GlobalSequence/quadulator/hardware/schematic.pdf

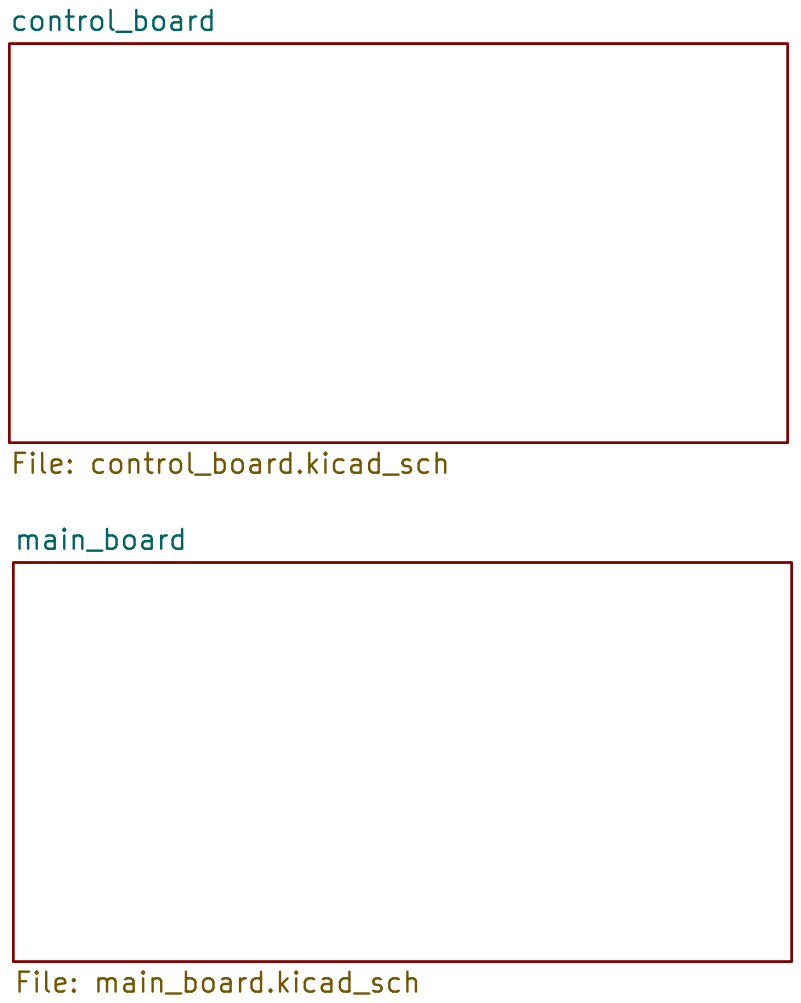
[picture p1: page 1]

Id: 1/3 Title: File: 2024.11.21_quadulator_2.0.kicad_sch Sheet: / main_board File: main_board.kicad_sch

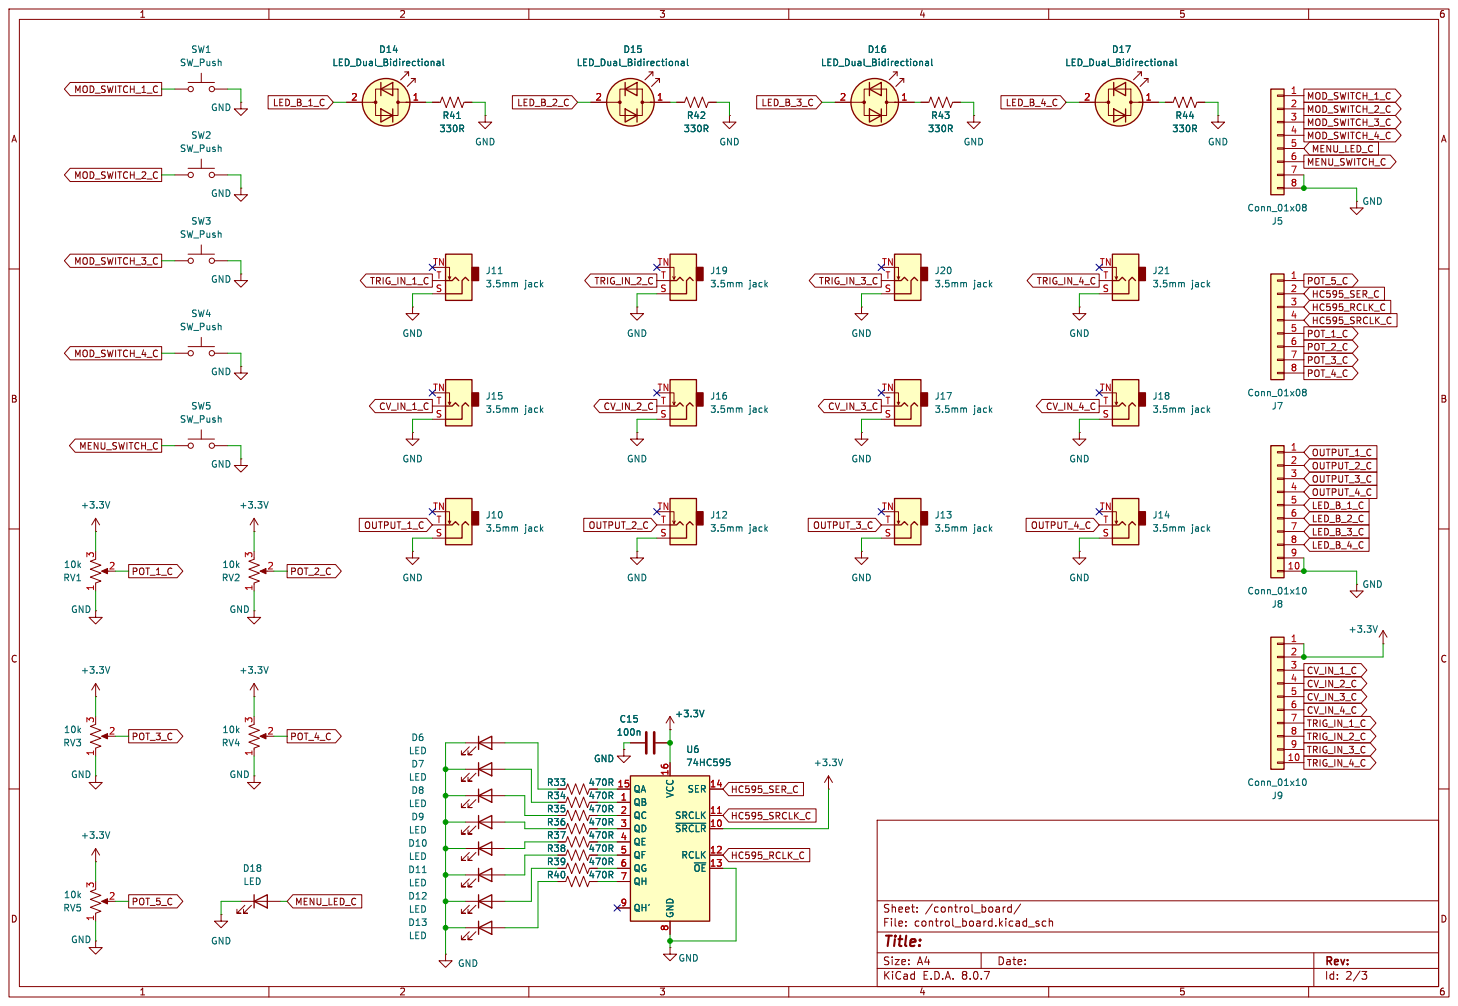
[picture p2: page 2]

Id: 2/3 Title: File: control_board.kicad_sch Sheet: /control_board/

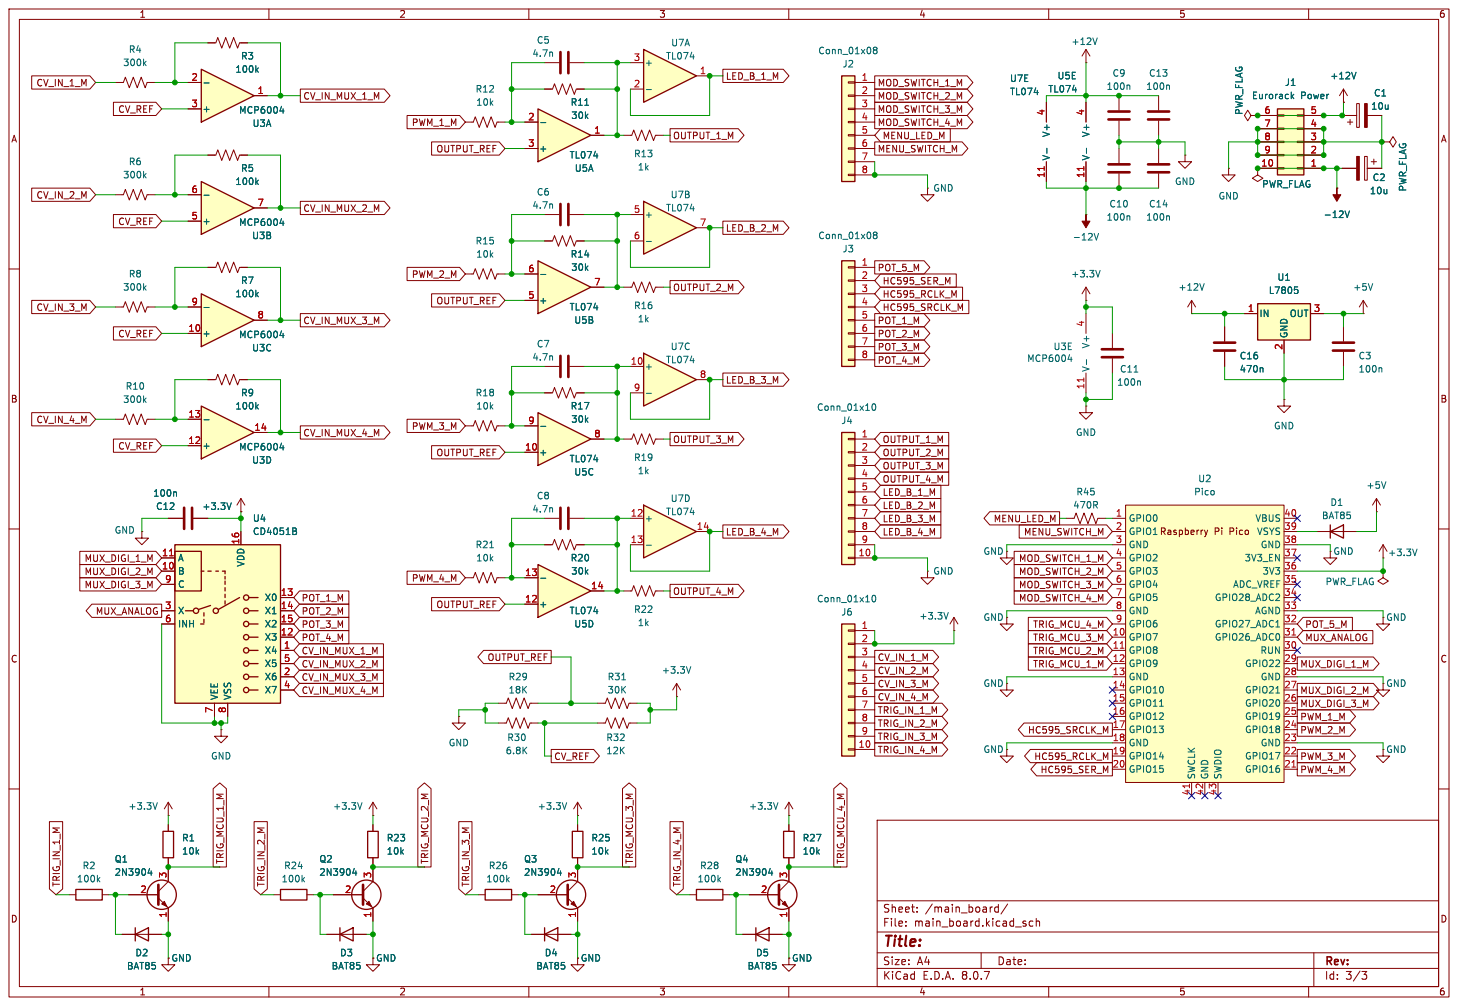
[picture p3: page 3]
