GlobalSequence/quadulator/hardware/quadulator.kicad_pcb

## KiCad design hardware/quadulator.kicad_pcb (2025-01-12)

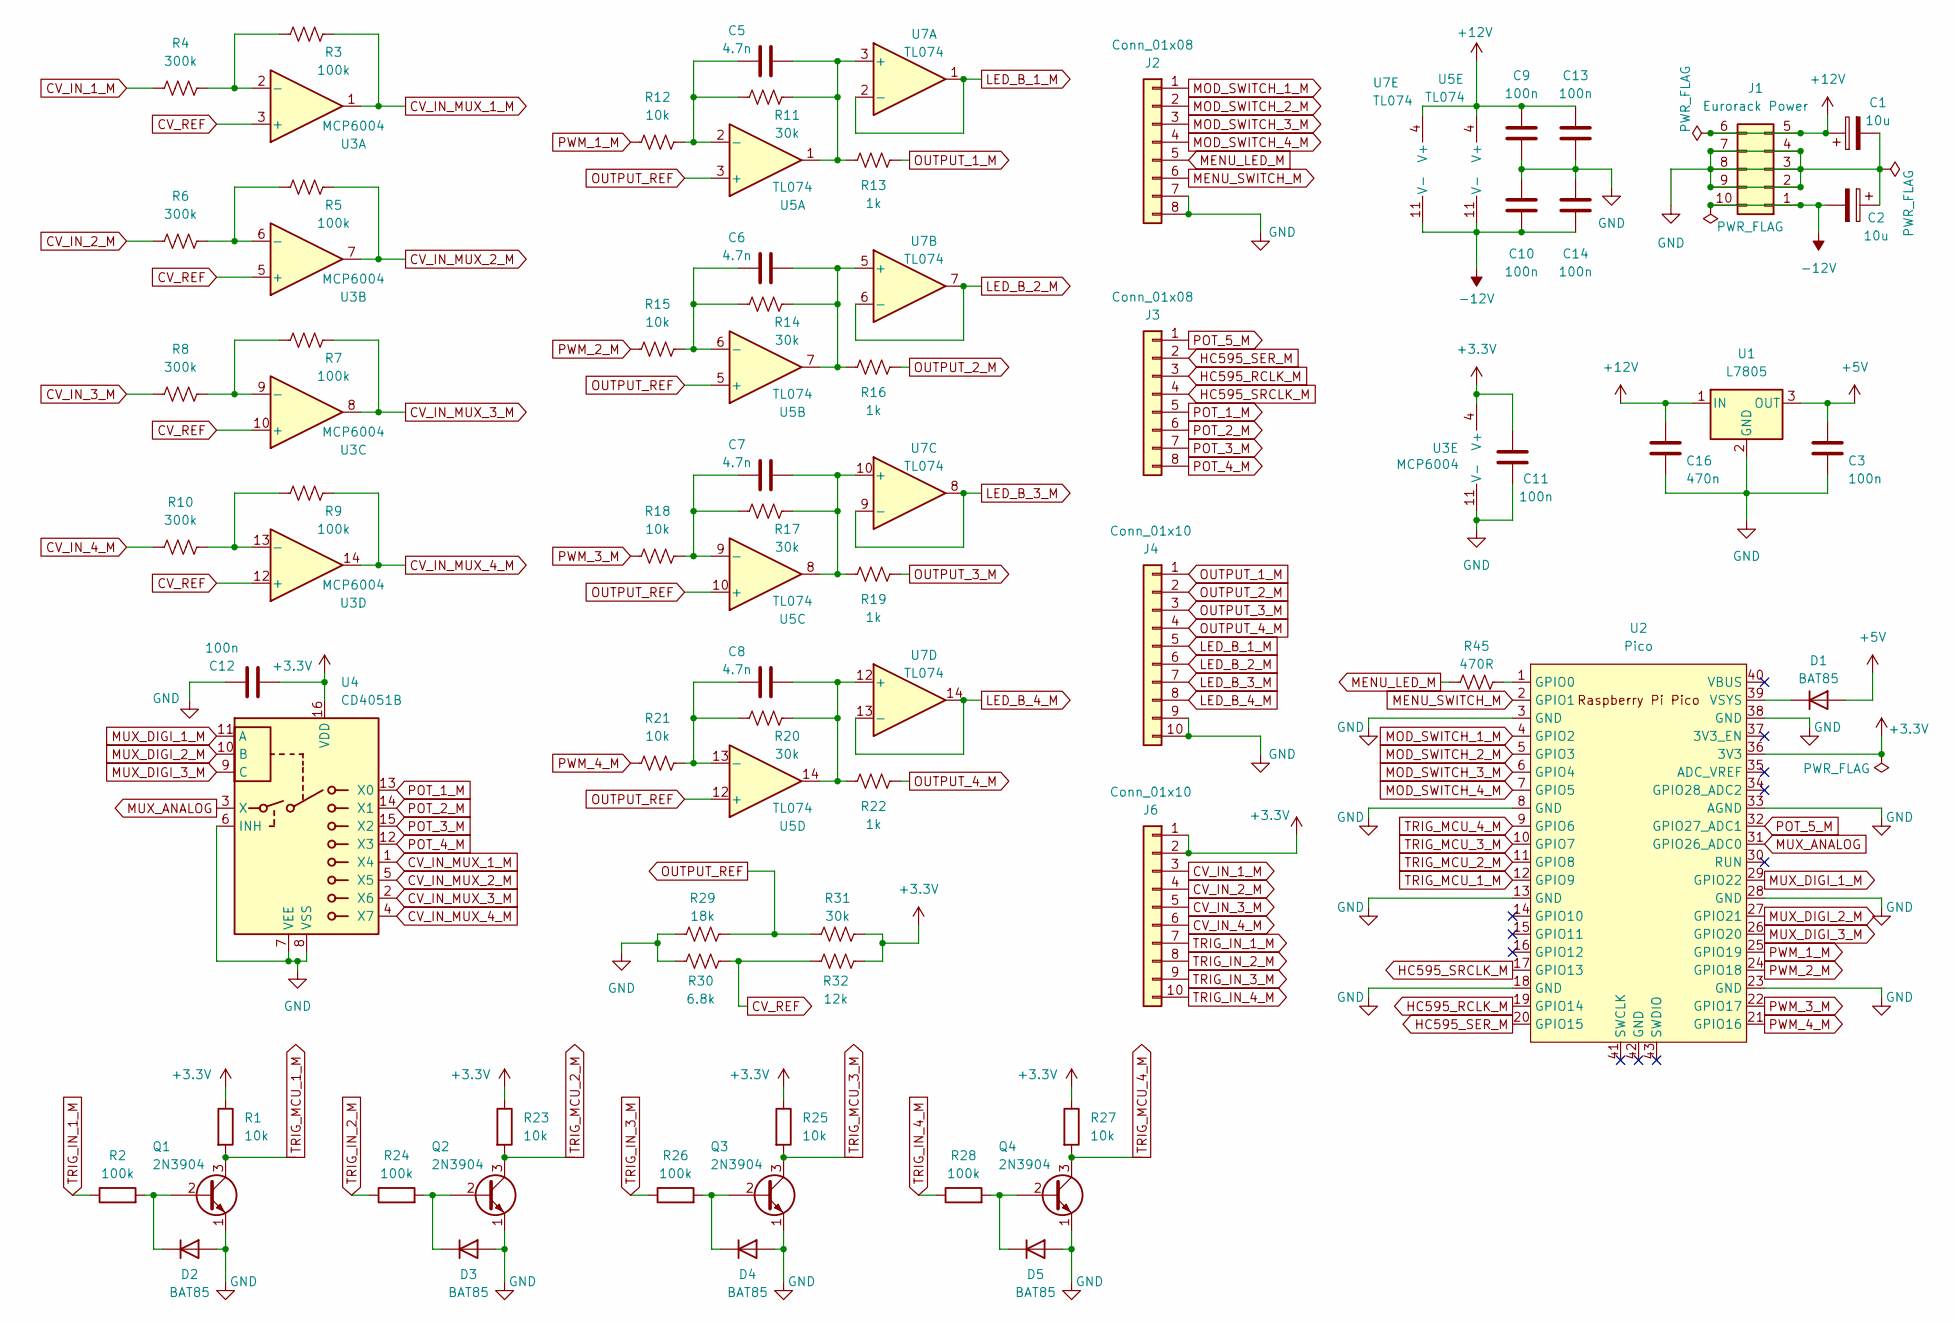
[picture p4: schematic main_board.kicad_sch]

Parts:
C1, C2: 10u; CP_Radial_D5.0mm_P2.50mm
C3, C9, C10, C11, C12, C13, C14: 100n; C_Disc_D5.0mm_W2.5mm_P5.00mm
C5, C6, C7, C8: 4.7n; C_Disc_D5.0mm_W2.5mm_P5.00mm
C16: 470n; C_Disc_D5.0mm_W2.5mm_P5.00mm
D1, D2, D3, D4, D5: BAT85; D_A-405_P7.62mm_Horizontal
J1: Eurorack Power; IDC-Header_2x05_P2.54mm_Vertical
J2, J3: Conn_01x08; PinSocket_1x08_P2.54mm_Vertical
J4, J6: Conn_01x10; PinSocket_1x10_P2.54mm_Vertical
Q1, Q2, Q3, Q4: 2N3904; TO-92L_Inline_Wide
R1, R12, R15, R18, R21, R23, R25, R27: 10k; R_Axial_DIN0207_L6.3mm_D2.5mm_P7.62mm_Horizontal
R2, R3, R5, R7, R9, R24, R26, R28: 100k; R_Axial_DIN0207_L6.3mm_D2.5mm_P7.62mm_Horizontal
R4, R6, R8, R10: 300k; R_Axial_DIN0207_L6.3mm_D2.5mm_P7.62mm_Horizontal
R11, R14, R17, R20, R31: 30k; R_Axial_DIN0207_L6.3mm_D2.5mm_P7.62mm_Horizontal
R13, R16, R19, R22: 1k; R_Axial_DIN0207_L6.3mm_D2.5mm_P7.62mm_Horizontal
R29: 18k; R_Axial_DIN0207_L6.3mm_D2.5mm_P7.62mm_Horizontal
R30: 6.8k; R_Axial_DIN0207_L6.3mm_D2.5mm_P7.62mm_Horizontal
R32: 12k; R_Axial_DIN0207_L6.3mm_D2.5mm_P7.62mm_Horizontal
R45: 470R; R_Axial_DIN0207_L6.3mm_D2.5mm_P7.62mm_Horizontal
U1: L7805; TO-220-3_Vertical
U2: Pico; RPi_Pico_SMD_TH
U3: MCP6004; DIP-14_W7.62mm_Socket
U4: CD4051B; DIP-16_W7.62mm_Socket
U5, U7: TL074; DIP-14_W7.62mm_Socket

Connections:
+3.3V: C11.1, C12.2, J6.1, J6.2, R1.1, R23.1, R25.1, R27.1, R31.2, R32.1, U2.36 (3V3), U3.4 (V+), U4.16 (VDD); also elsewhere on the board
+5V: C3.1, D1.2 (A), U1.3 (OUT)
+12V: C1.1, C9.1, C13.1, C16.1, J1.5, J1.6, U1.1 (IN), U5.4 (V+), U7.4 (V+)
-12V: C2.2, C10.2, C14.2, J1.1, J1.10, U5.11 (V-), U7.11 (V-)
CV_IN_1_M: J6.3, R4.1
CV_IN_2_M: J6.4, R6.1
CV_IN_3_M: J6.5, R8.1
CV_IN_4_M: J6.6, R10.1
CV_IN_MUX_1_M: R3.2, U3.1, U4.1 (X4)
CV_IN_MUX_2_M: R5.2, U3.7, U4.5 (X5)
CV_IN_MUX_3_M: R7.2, U3.8, U4.2 (X6)
CV_IN_MUX_4_M: R9.2, U3.14, U4.4 (X7)
CV_REF: R30.1, R32.2, U3.3 (+), U3.5 (+), U3.10 (+), U3.12 (+)
GND: C1.2, C2.1, C3.2, C9.2, C10.1, C11.2, C12.1, C13.2, C14.1, C16.2, D2.2 (A), D3.2 (A), D4.2 (A), D5.2 (A), J1.2, J1.3, J1.4, J1.7, J1.8, J1.9, J2.7, J2.8, J4.9, J4.10, Q1.1 (E), Q2.1 (E), Q3.1 (E), Q4.1 (E), R29.1, R30.2, U1.2 (GND), U2.3 (GND), U2.8 (GND), U2.13 (GND), U2.18 (GND), U2.23 (GND), U2.28 (GND), U2.33 (AGND), U2.38 (GND), U3.11 (V-), U4.6 (INH), U4.7 (VEE), U4.8 (VSS); also elsewhere on the board
HC595_RCLK_M: J3.3, U2.19 (GPIO14)
HC595_SER_M: J3.2, U2.20 (GPIO15)
HC595_SRCLK_M: J3.4, U2.17 (GPIO13)
LED_B_1_M: J4.5, U7.1, U7.2 (-)
LED_B_2_M: J4.6, U7.6 (-), U7.7
LED_B_3_M: J4.7, U7.8, U7.9 (-)
LED_B_4_M: J4.8, U7.13 (-), U7.14
MENU_LED_M: J2.5, R45.1
MENU_SWITCH_M: J2.6, U2.2 (GPIO1)
MOD_SWITCH_1_M: J2.1, U2.4 (GPIO2)
MOD_SWITCH_2_M: J2.2, U2.5 (GPIO3)
MOD_SWITCH_3_M: J2.3, U2.6 (GPIO4)
MOD_SWITCH_4_M: J2.4, U2.7 (GPIO5)
MUX_ANALOG: U2.31 (GPIO26_ADC0), U4.3 (X)
MUX_DIGI_1_M: U2.29 (GPIO22), U4.11 (A)
MUX_DIGI_2_M: U2.27 (GPIO21), U4.10 (B)
MUX_DIGI_3_M: U2.26 (GPIO20), U4.9 (C)
unnamed: D1.1 (K), U2.39 (VSYS)
unnamed: D2.1 (K), Q1.2 (B), R2.2
unnamed: D3.1 (K), Q2.2 (B), R24.2
unnamed: D4.1 (K), Q3.2 (B), R26.2
unnamed: D5.1 (K), Q4.2 (B), R28.2
unnamed: R45.2, U2.1 (GPIO0)
unnamed: R3.1, R4.2, U3.2 (-)
unnamed: R5.1, R6.2, U3.6 (-)
unnamed: R7.1, R8.2, U3.9 (-)
unnamed: R9.1, R10.2, U3.13 (-)
unnamed: C5.1, R11.1, R12.2, U5.2 (-)
unnamed: C6.1, R14.1, R15.2, U5.6 (-)
unnamed: C7.1, R17.1, R18.2, U5.9 (-)
unnamed: C8.1, R20.1, R21.2, U5.13 (-)
unnamed: C5.2, R11.2, R13.1, U5.1, U7.3 (+)
unnamed: C6.2, R14.2, R16.1, U5.7, U7.5 (+)
unnamed: C7.2, R17.2, R19.1, U5.8, U7.10 (+)
unnamed: C8.2, R20.2, R22.1, U5.14, U7.12 (+)
OUTPUT_1_M: J4.1, R13.2
OUTPUT_2_M: J4.2, R16.2
OUTPUT_3_M: J4.3, R19.2
OUTPUT_4_M: J4.4, R22.2
OUTPUT_REF: R29.2, R31.1, U5.3 (+), U5.5 (+), U5.10 (+), U5.12 (+)
POT_1_M: J3.5, U4.13 (X0)
POT_2_M: J3.6, U4.14 (X1)
POT_3_M: J3.7, U4.15 (X2)
POT_4_M: J3.8, U4.12 (X3)
POT_5_M: J3.1, U2.32 (GPIO27_ADC1)
PWM_1_M: R12.1, U2.25 (GPIO19)
PWM_2_M: R15.1, U2.24 (GPIO18)
PWM_3_M: R18.1, U2.22 (GPIO17)
PWM_4_M: R21.1, U2.21 (GPIO16)
TRIG_IN_1_M: J6.7, R2.1
TRIG_IN_2_M: J6.8, R24.1
TRIG_IN_3_M: J6.9, R26.1
TRIG_IN_4_M: J6.10, R28.1
TRIG_MCU_1_M: Q1.3 (C), R1.2, U2.12 (GPIO9)
TRIG_MCU_2_M: Q2.3 (C), R23.2, U2.11 (GPIO8)
TRIG_MCU_3_M: Q3.3 (C), R25.2, U2.10 (GPIO7)
TRIG_MCU_4_M: Q4.3 (C), R27.2, U2.9 (GPIO6)

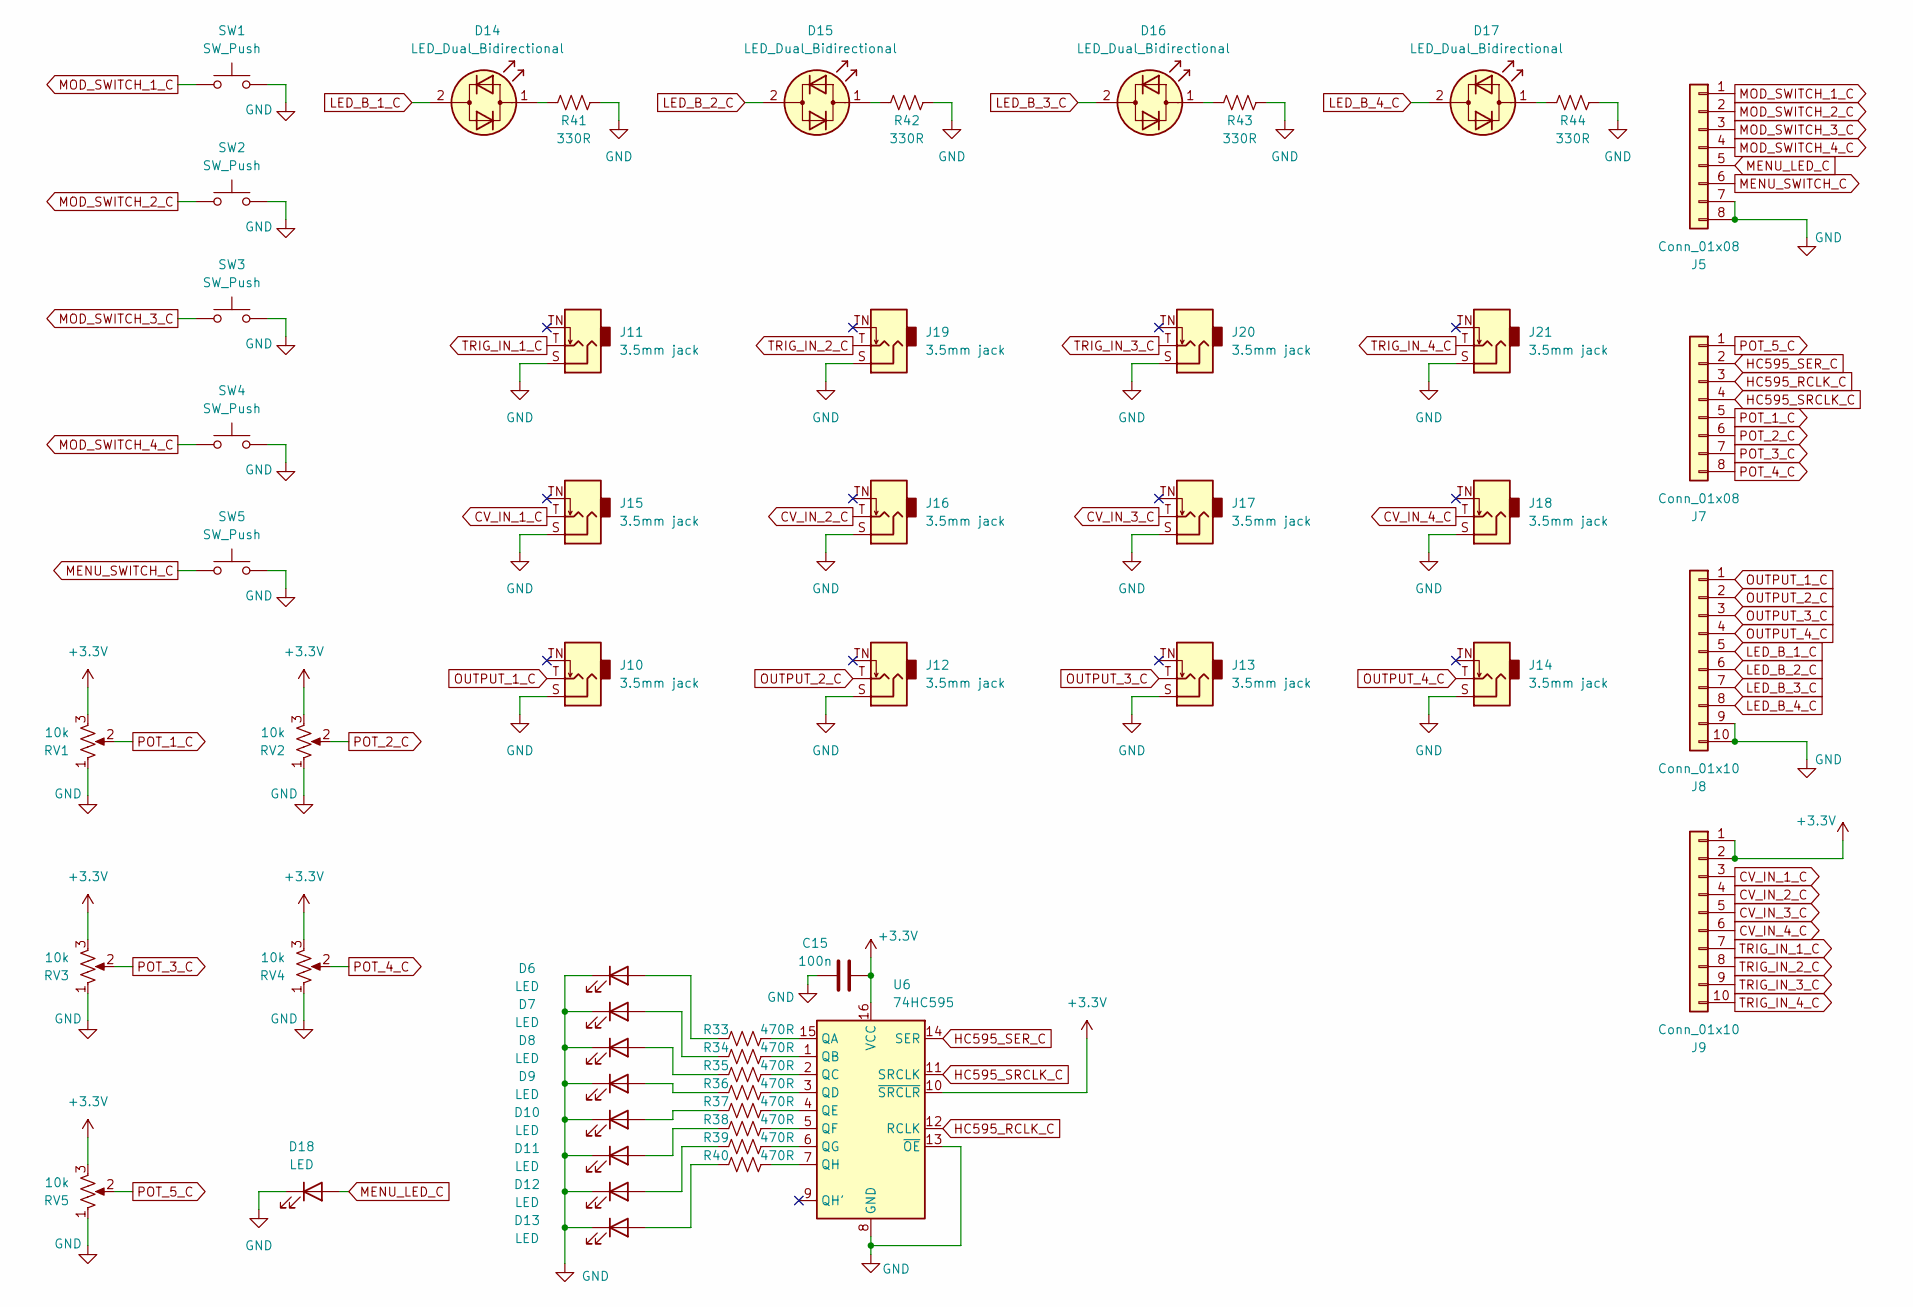
[picture p5: schematic control_board.kicad_sch]

Parts:
C15: 100n; C_Disc_D5.0mm_W2.5mm_P5.00mm
D6, D7, D8, D9, D10, D11, D12, D13, D18: LED; LED_D3.0mm
D14, D15, D16, D17: LED_Dual_Bidirectional; LED_D5.0mm
J5, J7: Conn_01x08; PinSocket_1x08_P2.54mm_Vertical
J8, J9: Conn_01x10; PinSocket_1x10_P2.54mm_Vertical
J10, J11, J12, J13, J14, J15, J16, J17, J18, J19, J20, J21: 3.5mm jack; Jack_3.5mm_QingPu_WQP-PJ398SM_Vertical_CircularHoles
R33, R34, R35, R36, R37, R38, R39, R40: 470R; R_Axial_DIN0207_L6.3mm_D2.5mm_P7.62mm_Horizontal
R41, R42, R43, R44: 330R; R_Axial_DIN0207_L6.3mm_D2.5mm_P7.62mm_Horizontal
RV1, RV2, RV3, RV4, RV5: 10k; Potentiometer_Alps_RK09K_Single_Vertical
SW1, SW2, SW3, SW4, SW5: SW_Push; SW_PUSH_6mm
U6: 74HC595; DIP-16_W7.62mm_Socket

Connections:
+3.3V: C15.2, J9.1, J9.2, RV1.3, RV2.3, RV3.3, RV4.3, RV5.3, U6.10 (~SRCLR), U6.16 (VCC); also elsewhere on the board
CV_IN_1_C: J9.3, J15.T
CV_IN_2_C: J9.4, J16.T
CV_IN_3_C: J9.5, J17.T
CV_IN_4_C: J9.6, J18.T
GND: C15.1, D6.1 (K), D7.1 (K), D8.1 (K), D9.1 (K), D10.1 (K), D11.1 (K), D12.1 (K), D13.1 (K), D18.1 (K), J5.7, J5.8, J8.9, J8.10, J10.S, J11.S, J12.S, J13.S, J14.S, J15.S, J16.S, J17.S, J18.S, J19.S, J20.S, J21.S, R41.2, R42.2, R43.2, R44.2, RV1.1, RV2.1, RV3.1, RV4.1, RV5.1, SW1.2, SW2.2, SW3.2, SW4.2, SW5.2, U6.8 (GND), U6.13 (~OE); also elsewhere on the board
HC595_RCLK_C: J7.3, U6.12 (RCLK)
HC595_SER_C: J7.2, U6.14 (SER)
HC595_SRCLK_C: J7.4, U6.11 (SRCLK)
LED_B_1_C: D14.2 (AK), J8.5
LED_B_2_C: D15.2 (AK), J8.6
LED_B_3_C: D16.2 (AK), J8.7
LED_B_4_C: D17.2 (AK), J8.8
MENU_LED_C: D18.2 (A), J5.5
MENU_SWITCH_C: J5.6, SW5.1
MOD_SWITCH_1_C: J5.1, SW1.1
MOD_SWITCH_2_C: J5.2, SW2.1
MOD_SWITCH_3_C: J5.3, SW3.1
MOD_SWITCH_4_C: J5.4, SW4.1
unnamed: D6.2 (A), R33.1
unnamed: D7.2 (A), R34.1
unnamed: D8.2 (A), R35.1
unnamed: D9.2 (A), R36.1
unnamed: D10.2 (A), R37.1
unnamed: D11.2 (A), R38.1
unnamed: D12.2 (A), R39.1
unnamed: D13.2 (A), R40.1
unnamed: D14.1 (KA), R41.1
unnamed: D15.1 (KA), R42.1
unnamed: D16.1 (KA), R43.1
unnamed: D17.1 (KA), R44.1
unnamed: R33.2, U6.15 (QA)
unnamed: R34.2, U6.1 (QB)
unnamed: R35.2, U6.2 (QC)
unnamed: R36.2, U6.3 (QD)
unnamed: R37.2, U6.4 (QE)
unnamed: R38.2, U6.5 (QF)
unnamed: R39.2, U6.6 (QG)
unnamed: R40.2, U6.7 (QH)
OUTPUT_1_C: J8.1, J10.T
OUTPUT_2_C: J8.2, J12.T
OUTPUT_3_C: J8.3, J13.T
OUTPUT_4_C: J8.4, J14.T
POT_1_C: J7.5, RV1.2
POT_2_C: J7.6, RV2.2
POT_3_C: J7.7, RV3.2
POT_4_C: J7.8, RV4.2
POT_5_C: J7.1, RV5.2
TRIG_IN_1_C: J9.7, J11.T
TRIG_IN_2_C: J9.8, J19.T
TRIG_IN_3_C: J9.9, J20.T
TRIG_IN_4_C: J9.10, J21.T

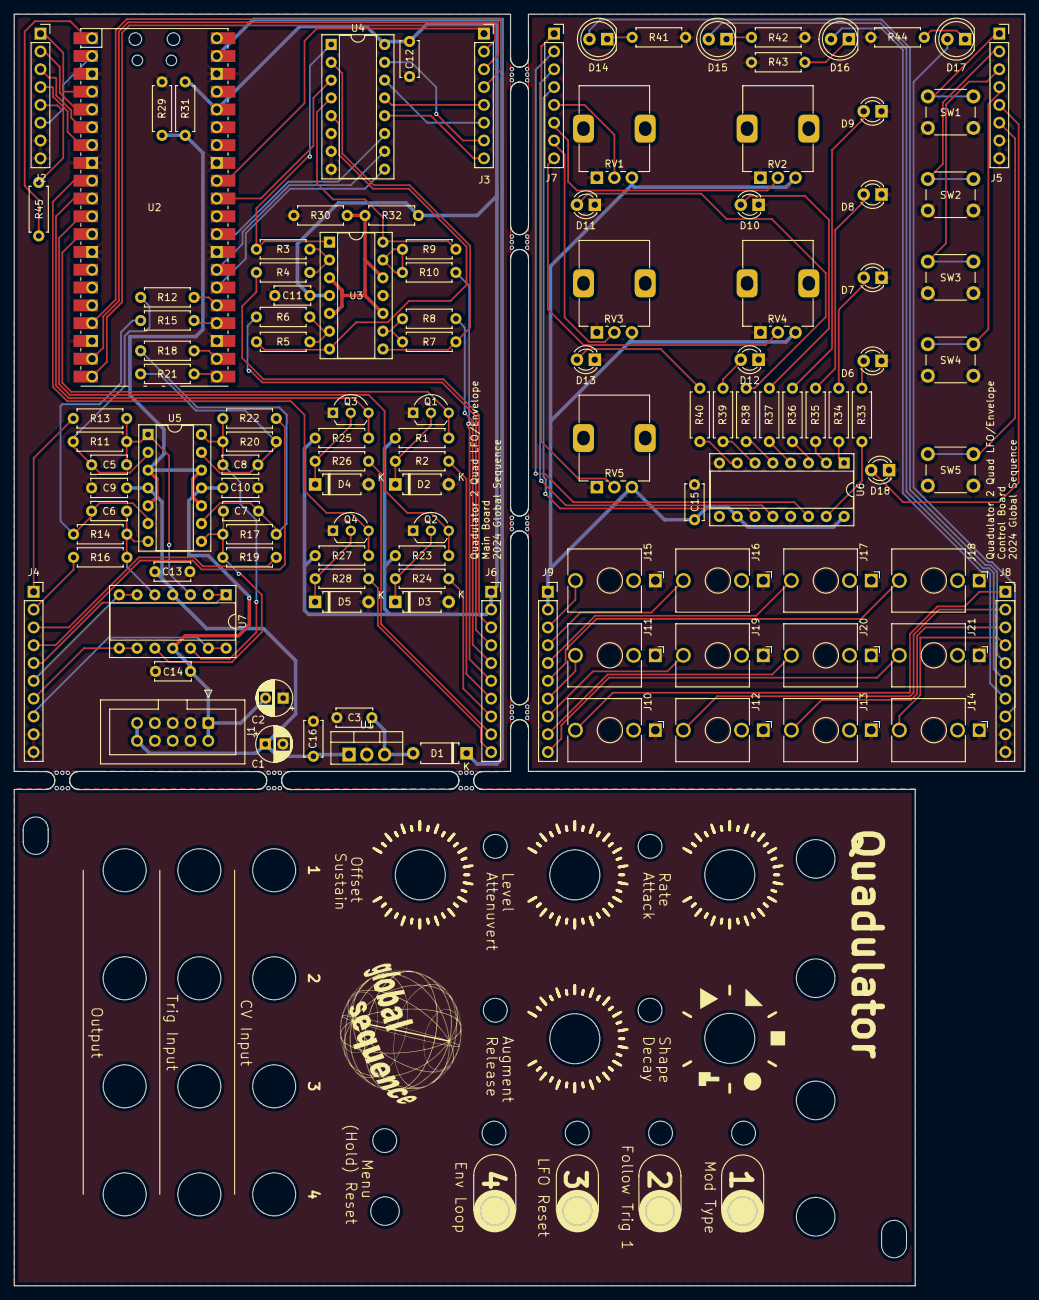
[picture p6: board quadulator.kicad_pcb from above]

Board: 2 copper layers, 144.1 x 181.4 mm, 127 parts (0 on the bottom side), 121 nets.

Other parts of the board:
mouse-bite-2.54mm-slot, mouse-bite-2.54mm-slot#2, mouse-bite-2.54mm-slot#3, mouse-bite-2.54mm-slot#4, mouse-bite-2.54mm-slot#5, mouse-bite-2.54mm-slot#6, mouse-bite-2.54mm-slot#7: VAL**; mouse-bite-2.54mm-slot
