GlobalSequence/quadulator/software/src/lfo.h

#ifndef LFO_H
#define LFO_H

#include <Arduino.h>
#include "math.h"
#include "noise.h"

// #define USING_ATMEGA328P

const uint16_t lfo_sine[] PROGMEM = {
	0x800,0x803,0x806,0x809,0x80c,0x80f,0x812,0x815,0x819,0x81c,0x81f,0x822,0x825,0x828,0x82b,0x82f,
0x832,0x835,0x838,0x83b,0x83e,0x841,0x845,0x848,0x84b,0x84e,0x851,0x854,0x857,0x85b,0x85e,0x861,
0x864,0x867,0x86a,0x86d,0x871,0x874,0x877,0x87a,0x87d,0x880,0x883,0x886,0x88a,0x88d,0x890,0x893,
0x896,0x899,0x89c,0x8a0,0x8a3,0x8a6,0x8a9,0x8ac,0x8af,0x8b2,0x8b5,0x8b9,0x8bc,0x8bf,0x8c2,0x8c5,
0x8c8,0x8cb,0x8ce,0x8d2,0x8d5,0x8d8,0x8db,0x8de,0x8e1,0x8e4,0x8e7,0x8eb,0x8ee,0x8f1,0x8f4,0x8f7,
0x8fa,0x8fd,0x900,0x903,0x907,0x90a,0x90d,0x910,0x913,0x916,0x919,0x91c,0x91f,0x923,0x926,0x929,
0x92c,0x92f,0x932,0x935,0x938,0x93b,0x93f,0x942,0x945,0x948,0x94b,0x94e,0x951,0x954,0x957,0x95a,
0x95e,0x961,0x964,0x967,0x96a,0x96d,0x970,0x973,0x976,0x979,0x97c,0x980,0x983,0x986,0x989,0x98c,
0x98f,0x992,0x995,0x998,0x99b,0x99e,0x9a1,0x9a4,0x9a8,0x9ab,0x9ae,0x9b1,0x9b4,0x9b7,0x9ba,0x9bd,
0x9c0,0x9c3,0x9c6,0x9c9,0x9cc,0x9cf,0x9d2,0x9d6,0x9d9,0x9dc,0x9df,0x9e2,0x9e5,0x9e8,0x9eb,0x9ee,
0x9f1,0x9f4,0x9f7,0x9fa,0x9fd,0xa00,0xa03,0xa06,0xa09,0xa0c,0xa0f,0xa12,0xa15,0xa19,0xa1c,0xa1f,
0xa22,0xa25,0xa28,0xa2b,0xa2e,0xa31,0xa34,0xa37,0xa3a,0xa3d,0xa40,0xa43,0xa46,0xa49,0xa4c,0xa4f,
0xa52,0xa55,0xa58,0xa5b,0xa5e,0xa61,0xa64,0xa67,0xa6a,0xa6d,0xa70,0xa73,0xa76,0xa79,0xa7c,0xa7f,
0xa82,0xa85,0xa88,0xa8b,0xa8e,0xa91,0xa94,0xa97,0xa9a,0xa9d,0xaa0,0xaa2,0xaa5,0xaa8,0xaab,0xaae,
0xab1,0xab4,0xab7,0xaba,0xabd,0xac0,0xac3,0xac6,0xac9,0xacc,0xacf,0xad2,0xad5,0xad8,0xadb,0xadd,
0xae0,0xae3,0xae6,0xae9,0xaec,0xaef,0xaf2,0xaf5,0xaf8,0xafb,0xafe,0xb01,0xb03,0xb06,0xb09,0xb0c,
0xb0f,0xb12,0xb15,0xb18,0xb1b,0xb1e,0xb20,0xb23,0xb26,0xb29,0xb2c,0xb2f,0xb32,0xb35,0xb37,0xb3a,
0xb3d,0xb40,0xb43,0xb46,0xb49,0xb4c,0xb4e,0xb51,0xb54,0xb57,0xb5a,0xb5d,0xb60,0xb62,0xb65,0xb68,
0xb6b,0xb6e,0xb71,0xb73,0xb76,0xb79,0xb7c,0xb7f,0xb82,0xb84,0xb87,0xb8a,0xb8d,0xb90,0xb92,0xb95,
0xb98,0xb9b,0xb9e,0xba0,0xba3,0xba6,0xba9,0xbac,0xbae,0xbb1,0xbb4,0xbb7,0xbba,0xbbc,0xbbf,0xbc2,
0xbc5,0xbc7,0xbca,0xbcd,0xbd0,0xbd3,0xbd5,0xbd8,0xbdb,0xbde,0xbe0,0xbe3,0xbe6,0xbe9,0xbeb,0xbee,
0xbf1,0xbf3,0xbf6,0xbf9,0xbfc,0xbfe,0xc01,0xc04,0xc06,0xc09,0xc0c,0xc0f,0xc11,0xc14,0xc17,0xc19,
0xc1c,0xc1f,0xc22,0xc24,0xc27,0xc2a,0xc2c,0xc2f,0xc32,0xc34,0xc37,0xc3a,0xc3c,0xc3f,0xc42,0xc44,
0xc47,0xc4a,0xc4c,0xc4f,0xc52,0xc54,0xc57,0xc59,0xc5c,0xc5f,0xc61,0xc64,0xc67,0xc69,0xc6c,0xc6e,
0xc71,0xc74,0xc76,0xc79,0xc7b,0xc7e,0xc81,0xc83,0xc86,0xc88,0xc8b,0xc8e,0xc90,0xc93,0xc95,0xc98,
0xc9a,0xc9d,0xca0,0xca2,0xca5,0xca7,0xcaa,0xcac,0xcaf,0xcb1,0xcb4,0xcb7,0xcb9,0xcbc,0xcbe,0xcc1,
0xcc3,0xcc6,0xcc8,0xccb,0xccd,0xcd0,0xcd2,0xcd5,0xcd7,0xcda,0xcdc,0xcdf,0xce1,0xce4,0xce6,0xce9,
0xceb,0xcee,0xcf0,0xcf3,0xcf5,0xcf8,0xcfa,0xcfc,0xcff,0xd01,0xd04,0xd06,0xd09,0xd0b,0xd0e,0xd10,
0xd12,0xd15,0xd17,0xd1a,0xd1c,0xd1f,0xd21,0xd23,0xd26,0xd28,0xd2b,0xd2d,0xd2f,0xd32,0xd34,0xd36,
0xd39,0xd3b,0xd3e,0xd40,0xd42,0xd45,0xd47,0xd49,0xd4c,0xd4e,0xd50,0xd53,0xd55,0xd58,0xd5a,0xd5c,
0xd5f,0xd61,0xd63,0xd65,0xd68,0xd6a,0xd6c,0xd6f,0xd71,0xd73,0xd76,0xd78,0xd7a,0xd7c,0xd7f,0xd81,
0xd83,0xd86,0xd88,0xd8a,0xd8c,0xd8f,0xd91,0xd93,0xd95,0xd98,0xd9a,0xd9c,0xd9e,0xda1,0xda3,0xda5,
0xda7,0xdaa,0xdac,0xdae,0xdb0,0xdb2,0xdb5,0xdb7,0xdb9,0xdbb,0xdbd,0xdc0,0xdc2,0xdc4,0xdc6,0xdc8,
0xdca,0xdcd,0xdcf,0xdd1,0xdd3,0xdd5,0xdd7,0xdd9,0xddc,0xdde,0xde0,0xde2,0xde4,0xde6,0xde8,0xdea,
0xded,0xdef,0xdf1,0xdf3,0xdf5,0xdf7,0xdf9,0xdfb,0xdfd,0xdff,0xe02,0xe04,0xe06,0xe08,0xe0a,0xe0c,
0xe0e,0xe10,0xe12,0xe14,0xe16,0xe18,0xe1a,0xe1c,0xe1e,0xe20,0xe22,0xe24,0xe26,0xe28,0xe2a,0xe2c,
0xe2e,0xe30,0xe32,0xe34,0xe36,0xe38,0xe3a,0xe3c,0xe3e,0xe40,0xe42,0xe44,0xe46,0xe48,0xe4a,0xe4c,
0xe4e,0xe50,0xe51,0xe53,0xe55,0xe57,0xe59,0xe5b,0xe5d,0xe5f,0xe61,0xe63,0xe65,0xe66,0xe68,0xe6a,
0xe6c,0xe6e,0xe70,0xe72,0xe74,0xe75,0xe77,0xe79,0xe7b,0xe7d,0xe7f,0xe80,0xe82,0xe84,0xe86,0xe88,
0xe8a,0xe8b,0xe8d,0xe8f,0xe91,0xe92,0xe94,0xe96,0xe98,0xe9a,0xe9b,0xe9d,0xe9f,0xea1,0xea2,0xea4,
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
};

#define LFO_DEFAULT_RESOLUTION_BITS 12
#define BIT_CEILING (1 << LFO_DEFAULT_RESOLUTION_BITS)
#define MAX_LFO_LEVEL (BIT_CEILING - 1)
#define HALF_MAX_LFO_LEVEL (BIT_CEILING / 2)
#define PHASE180 128
// #define MAX_LFO_LEVEL 4095
// #define BIT_CEILING MAX_LFO_LEVEL + 1
// #define HALF_MAX_LFO_LEVEL (MAX_LFO_LEVEL +  1) / 2
#define MOVING_AVERAGE_BUFFER_SIZE 32

enum WaveForm
{
    LFO_TRIANGLE,
    LFO_SAW,
    //reverse_LFO_SAW,
    LFO_SQUARE,
    LFO_SINE,
    LFO_SAMPLE_HOLD,
    NUMBER_OF_LFO_SHAPES
};

typedef struct Saw_Params {
  bool extend_phase;
  uint16_t last_sample;
} SawParams;

typedef struct Sample_Hold_Params {
  uint8_t counter_;
  uint32_t total_;
  uint16_t buffer_[MOVING_AVERAGE_BUFFER_SIZE];
} Sample_Hold_Params;

typedef struct LFO_Params {
    uint16_t phase_;
    uint16_t phase_12b_;
    uint16_t phase_increment_;
    uint16_t previous_phase_;
    uint16_t phase_shift_;
    uint8_t step_ = 0;
    uint8_t wave_ = 0;
    uint8_t level_ = 0;
    uint16_t seed_ = 0x420;
    uint8_t augment_ = 0;
    uint16_t bias_ = 0;
    uint8_t bias_multiplier_;

    bool sh_this_step_bool_;
    bool sh_last_step_bool_;
    uint16_t hold_sample_;

    bool reset_ = false;
    bool sync_ = false;
    xorShiftVariables lfoNoise;
    SawParams s;
    Sample_Hold_Params sh;
} LFO_Params;

void LFOSetup(LFO_Params* l, uint32_t seed) {

  xorShift128Init(&l->lfoNoise, seed);
}

void LFOUpdate(LFO_Params* l, uint16_t freq, uint8_t wave, uint8_t phase_shift, uint8_t augment, uint8_t bias) {

  l->phase_increment_ = freq;
  l->wave_ = wave;
  l->phase_shift_ = phase_shift;
  l->augment_ = augment;
  l->bias_ = (bias << 3);
}

uint16_t foldWave(uint16_t sample, uint8_t amt) {

  int32_t sample_32s;
  int32_t v;
  sample_32s = sample;
  sample_32s -= HALF_MAX_LFO_LEVEL;
  sample_32s = (sample_32s + (sample_32s * (amt) >> 7)); //double the wave level. fixed point fractional.
  if(sample_32s >= HALF_MAX_LFO_LEVEL) {
    v = sample_32s - HALF_MAX_LFO_LEVEL;
    sample_32s = HALF_MAX_LFO_LEVEL - v;
  } else if (sample_32s <= (-HALF_MAX_LFO_LEVEL)) {
    v = (-HALF_MAX_LFO_LEVEL) - sample_32s ;
    sample_32s = (-HALF_MAX_LFO_LEVEL) + v;
  }
  sample_32s += HALF_MAX_LFO_LEVEL;
  if(sample_32s >= MAX_LFO_LEVEL) sample_32s = MAX_LFO_LEVEL;
  return sample_32s;
}

uint16_t augmentSaw(Saw_Params* s, uint16_t sample, uint8_t amt) {

  return sample <= amt << 4 ? sample : BIT_CEILING - sample;

  // uint16_t phase_extender;
  // if(s->last_sample > sample) {
  //   s->extend_phase = s->extend_phase == true? false : true;
  // }
  // if(s->extend_phase) {
  //   phase_extender = BIT_CEILING + sample;
  // } else {
  //   phase_extender = sample;
  // }
  // s->last_sample = sample;
  // uint16_t output_sample;
  // phase_extender <= (amt << 5) ? output_sample = (int16_t)(phase_extender - 8192) * (-1) : output_sample = phase_extender/*  * 2 */;
  // return output_sample >> 1;
}

uint16_t augmentSine(uint16_t sample, uint16_t amt) {

  uint16_t phase_mod = sample + (amt << 4);
  if(phase_mod > MAX_LFO_LEVEL) {
    phase_mod -= MAX_LFO_LEVEL;
  }
  return phase_mod;
}

uint16_t augmentSampleHold(Sample_Hold_Params* sh, uint16_t sample, uint8_t amt) {

  static uint16_t current_val = 0;
  uint8_t inv_amt = ~amt;
  float step_size = inv_amt / 255.0f;
  int16_t difference = sample - current_val;
  current_val += (int16_t)(difference * step_size);
  return current_val;
}

uint16_t LFORender(LFO_Params* l) {

  l->phase_ += l->phase_increment_;
  uint16_t phase_out_ = l->phase_ + (l->phase_shift_ << 8);
  l->step_ = phase_out_ >> 8;
  l->phase_12b_ = phase_out_ >> 4;

  uint16_t sample;

  switch (l->wave_)
  {
  case LFO_TRIANGLE:
      l->step_ >= PHASE180 ? sample = (int16_t)(l->phase_12b_ - 4096) * (-2) : sample = l->phase_12b_ * 2;
      if (sample >= MAX_LFO_LEVEL) sample = MAX_LFO_LEVEL;
      sample = foldWave(sample, l->augment_);
      break;

  case LFO_SAW:
      sample = augmentSaw(&l->s, l->phase_12b_, l->augment_);
      break;

  // case reverse_LFO_SAW:
  //     sample = ~phase_12b_;
  //     break;

  case LFO_SQUARE:
      l->step_ >= (uint8_t)(l->augment_ - 128) ? sample = 0 : sample = MAX_LFO_LEVEL;
      break;

  case LFO_SINE:
      sample = /* sine_wavetable[step_] */
#ifndef USING_ATMEGA328P
      // lfo_sine[augmentSine(l->phase_12b_, l->augment_)];
      sample = foldWave(lfo_sine[l->phase_12b_], l->augment_);
#else
      pgm_read_word(&lfo_sine[augmentSine(l->phase_12b_, l->augment_)]);
#endif
      break;

  case LFO_SAMPLE_HOLD:

      // l->sh_this_step_bool_ = l->step_ >= PHASE180? true : false;
      // if (l->sh_this_step_bool_ != l->sh_last_step_bool_)
      // {
      //     sample = xorShift128(&l->lfoNoise) >> 20;
      //     l->hold_sample_ = sample;
      // }
      // else
      // {
      //     sample = l->hold_sample_;
      // }
      // l->sh_last_step_bool_ = l->sh_this_step_bool_;
      
      
      if (l->previous_phase_ > l->phase_)
      {
          sample = xorShift128(&l->lfoNoise) >> 20;
          l->hold_sample_ = sample;
      }
      else
      {
          sample = l->hold_sample_;
      }
      sample = augmentSampleHold(&l->sh, sample, l->augment_);
      break;
  }
  l->previous_phase_ = l->phase_;
  uint16_t output = sample + l->bias_;
  output = output >= MAX_LFO_LEVEL? MAX_LFO_LEVEL : output;
  return output;
}

void LFOReset(LFO_Params* l) {
    if(l->reset_) {
        l->phase_ = 0; 
        l->sh_last_step_bool_ = !l->sh_this_step_bool_;
    }
}

void LFOResetNow(LFO_Params* l) {
  l->phase_ = 0;
  l->sh_last_step_bool_ = !l->sh_this_step_bool_;
}

void LFOSetReset(LFO_Params* l, bool reset) {l->reset_ = reset;}
void LFOSetSync(LFO_Params* l, bool sync) {l->sync_ = sync;}

bool LFOGetReset(LFO_Params* l) {return l->reset_;}
bool LFOGetSync(LFO_Params* l) {return l->sync_;}

uint16_t printPhase_12b(LFO_Params* l){return l->phase_12b_;}

// class LFO
// {
// public:
//     LFO() {}
//     void Update(uint16_t freq, uint8_t wave, uint8_t phase_shift)
//     {
//         phase_increment_ = freq;
//         wave_ = wave;
//         phase_shift_ = phase_shift;
//     }

//     uint16_t Render()
//     {
//         phase_ += phase_increment_;
//         uint16_t phase_out_ = phase_ + (phase_shift_ << 8);
//         step_ = phase_out_ >> 8;
//         phase_12b_ = phase_out_ >> 4;

//         uint16_t sample;

//         switch (wave_)
//         {
//         case LFO_TRIANGLE:
//             step_ >= PHASE180 ? sample = /* ~(phase_12b_ * 2) */(int16_t)(phase_12b_ - 4096) * (-2) : sample = phase_12b_ * 2;
//             if (sample >= MAX_LFO_LEVEL) sample = MAX_LFO_LEVEL;
//             break;

//         case LFO_SAW:
//             sample = phase_12b_;
//             break;

//         // case reverse_LFO_SAW:
//         //     sample = ~phase_12b_;
//         //     break;

//         case LFO_SQUARE:
//             step_ >= PHASE180 ? sample = 0 : sample = MAX_LFO_LEVEL;
//             break;

//         case sine:
//             sample = /* sine_wavetable[step_] */lfo_sine[phase_12b_];
//             break;

//         case LFO_SAMPLE_HOLD:

//             sh_this_step_bool_ = step_ >= PHASE180? true : false;
//             if (sh_this_step_bool_ != sh_last_step_bool_)
//             {
//                 seed_ -= 17;
//                 XOR798(&seed_);
//                 sample = seed_ >> 4;
//                 hold_sample_ = sample;
//             }
//             else
//             {
//                 sample = hold_sample_;
//             }
//             sh_last_step_bool_ = sh_this_step_bool_;
//             break;
//         }
//         return sample;
//     }

//     void reset() {
//         if(reset_) {
//             phase_ = 0; 
//             sh_last_step_bool_ = !sh_this_step_bool_;
//         }
//     }

//     void setReset(bool reset) {reset_ = reset;}
//     void setSync(bool sync) {sync_ = sync;}

//     bool getReset() {return reset_;}
//     bool getSync() {return sync_;}

//     uint16_t printPhase_12b(){return phase_12b_;}

// private:
//     uint16_t phase_;
//     uint16_t phase_12b_;
//     uint16_t phase_increment_;
//     uint16_t phase_shift_;
//     uint8_t step_ = 0;
//     uint8_t wave_ = 0;
//     uint8_t level_ = 0;
//     uint16_t seed_ = 0x420;

//     bool sh_this_step_bool_;
//     bool sh_last_step_bool_;
//     //uint8_t last_step_;
//     uint16_t hold_sample_;

//     bool reset_ = false;
//     bool sync_ = false;
// };

#endif
