GlobalSequence/quadulator/(commit log)

2025-01-09 created repository
    [control_board.kicad_sch, main_board.kicad_sch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]
2025-01-12 added bom
    [quadulator-bom.csv, quadulator.kicad_sch]
2025-01-12 updated bom
    [quadulator-bom.csv, quadulator.kicad_pcb]
2025-02-17 updated quadulator.pdf to schematic.pdf
